Bobe-Wang/CMSIS_DAP-STM32/doc/719f01f6-3b62-4f19-8413-66b5557dca3e.png

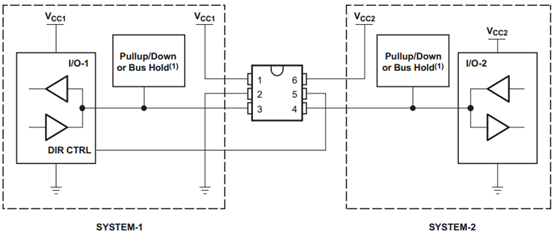
doc/719f01f6-3b62-4f19-8413-66b5557dca3e.png
