Bobe-Wang/CMSIS_DAP-STM32/原理图.pdf

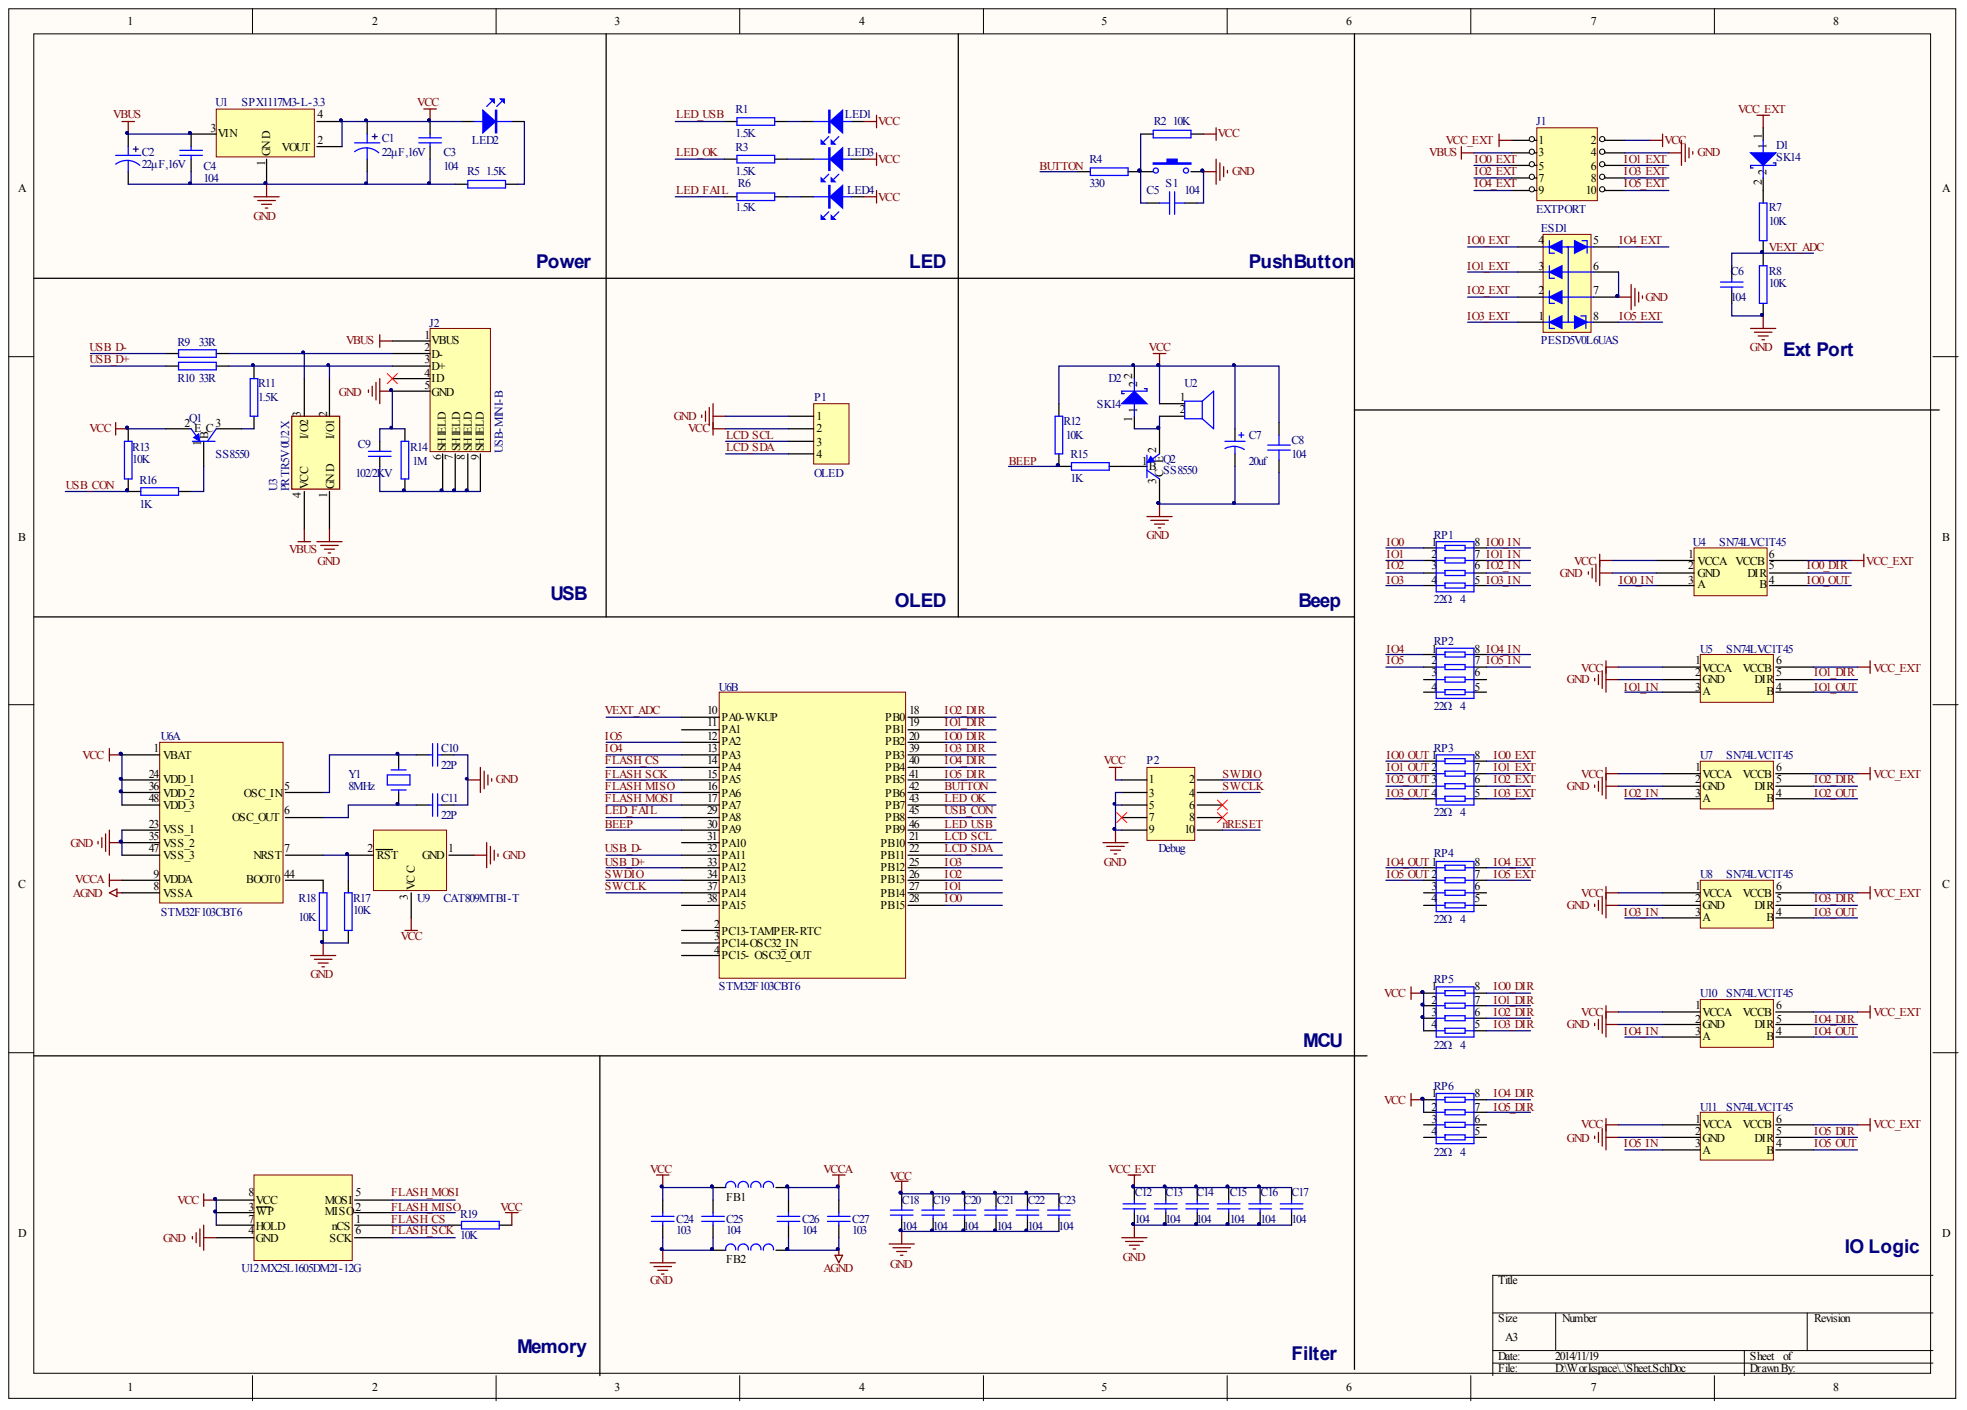
[picture p13: page 1]

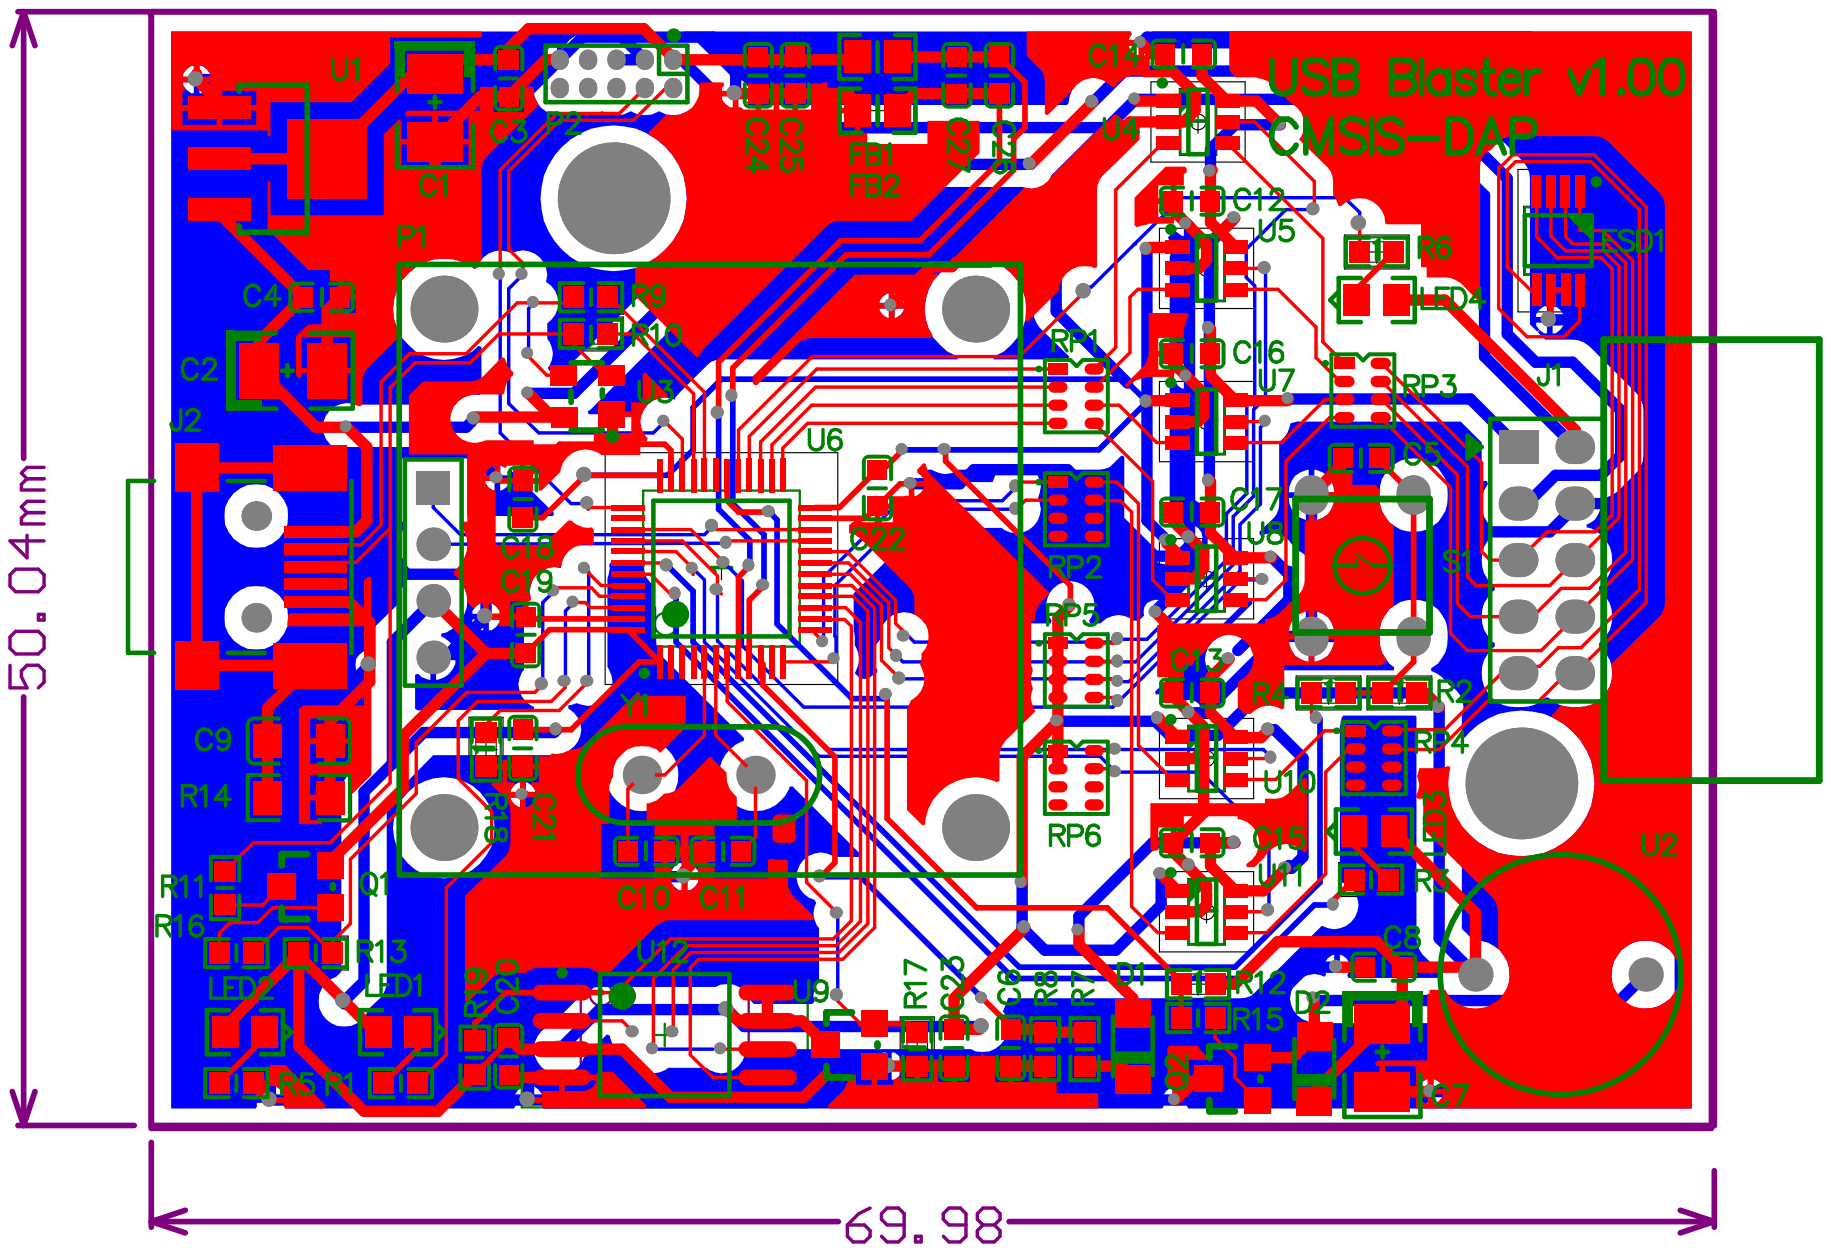
[picture p14: page 2]
