Bobe-Wang/CMSIS_DAP-STM32/code/Firmware/TinyICE/HID_MCBSTM32_LPC2138_TKScope.cfg

[Target]
Vendor=NXP
Device=LPC2138
HistoryVendorName0=
HistoryDeviceName0=
HistoryVendorName1=
HistoryDeviceName1=
HistoryVendorName2=
HistoryDeviceName2=
HistoryVendorName3=
HistoryDeviceName3=
[Emulator]
EmulatorType=K10
PodType=POD-JTAG-ARM-P20
EmulatorSN=0
[ConfigFile]
ConfigFile0=configuration\nxp\lpc21xx_iap1_512.flx
ConfigFile1=
ConfigFile2=
ConfigFile3=
ConfigFile4=hid_mcbstm32 lpc2138.ini
[Project]
ProjectName=HID_MCBSTM32.cfg
[CACHE]
CODE=0
DATA=0
[JTAG]
JtagFreq=1000
JtagFreqBak=100000
MinJtagFreq=1000
MaxJtagFreq=1200000
ResetHoldTime(ms)=0
ResetReleaseTime(ms)=0
ResetStrategy=CoreResetModeNo
HaltStrategy=HaltModeAuto
UseSWD=0
JtagClkMode=FixedJtagClock
UseLowFreqInit=0
UsenSRST=0
UsenTRST=0
AutoConfigJtag=0
ActiveDeviceID=0x0
ActiveDeviceNum=0
ActiveCoreNum=0
[Flash]
ProgramMode0=0
ProgramFlash0=0
Verify0=0
SkipMatch0=0
ProgramConfig0=0
EraseMode0=EraseNo
ResetAndRun0=0
UseDCC0=0
CommChannel0=0
FlashAlgoOffsetAdr0=0x0
FlashAlgoOffsetSize0=0x7d000
CodeRamAlgoOffsetAdr0=0x40000000
CodeRamAlgoOffsetSize0=0x1010
ProgramMode1=0
ProgramFlash1=0
Verify1=0
SkipMatch1=0
ProgramConfig1=0
EraseMode1=EraseNo
ResetAndRun1=0
UseDCC1=0
CommChannel1=0
FlashAlgoOffsetAdr1=0x0
FlashAlgoOffsetSize1=0x0
CodeRamAlgoOffsetAdr1=0x40000000
CodeRamAlgoOffsetSize1=0x0
ProgramMode2=0
ProgramFlash2=0
Verify2=0
SkipMatch2=0
ProgramConfig2=0
EraseMode2=EraseNo
ResetAndRun2=0
UseDCC2=0
CommChannel2=0
FlashAlgoOffsetAdr2=0x0
FlashAlgoOffsetSize2=0x0
CodeRamAlgoOffsetAdr2=0x40000000
CodeRamAlgoOffsetSize2=0x0
ProgramMode3=0
ProgramFlash3=0
Verify3=0
SkipMatch3=0
ProgramConfig3=0
EraseMode3=EraseNo
ResetAndRun3=0
UseDCC3=0
CommChannel3=0
FlashAlgoOffsetAdr3=0x0
FlashAlgoOffsetSize3=0x0
CodeRamAlgoOffsetAdr3=0x40000000
CodeRamAlgoOffsetSize3=0x0
[BaseDebug]
MemAccAttr=0
SoftStep=0
UseSoftWareBreakPoint=0
UseFlashBreakPoint=0
RunnigUpd=0
SysFreq=100000000
BreakTime=0
Endian=LittleEndian
DisableInitFile=0
[STANDARD ARM]
CaptureReset=0
CaptureUndef=0
CaptureSWI=0
CapturePabt=0
CaptureDabt=0
CaptureIRQ=0
CaptureFIQ=0
