Bobe-Wang/CMSIS_DAP-STM32/code/Firmware/TinyICE/HID_MCBSTM32_STM32F100xB_TKScope.cfg

[Target]
Vendor=STMicroelectronics
Device=STM32F100xB
HistoryVendorName0=
HistoryDeviceName0=
HistoryVendorName1=
HistoryDeviceName1=
HistoryVendorName2=
HistoryDeviceName2=
HistoryVendorName3=STMicroelectronics
HistoryDeviceName3=STM32F100xB
[Emulator]
EmulatorType=AK100pro
PodType=
EmulatorSN=500001189
[ConfigFile]
ConfigFile0=configuration\st\stm32f10x_128.flm
ConfigFile1=
ConfigFile2=
ConfigFile3=
ConfigFile4=hid_mcbstm32 stm32f100xb.ini
[Project]
ProjectName=HID_MCBSTM32.cfg
[CACHE]
CODE=1
DATA=1
[JTAG]
JtagFreq=100000
JtagFreqBak=800000
MinJtagFreq=100000
MaxJtagFreq=1200000
ResetHoldTime(ms)=506
ResetReleaseTime(ms)=500
ResetStrategy=CoreResetModeAuto
HaltStrategy=HaltModeAuto
UseSWD=1
JtagClkMode=FixedJtagClock
UseLowFreqInit=0
UsenSRST=1
UsenTRST=1
AutoConfigJtag=1
ActiveDeviceID=0x1BA01477
ActiveDeviceNum=0
ActiveCoreNum=0
[Flash]
ProgramMode0=0
ProgramFlash0=1
Verify0=1
SkipMatch0=0
ProgramConfig0=0
EraseMode0=EraseChip
ResetAndRun0=0
UseDCC0=0
CommChannel0=0
FlashAlgoOffsetAdr0=0x8000000
FlashAlgoOffsetSize0=0x20000
CodeRamAlgoOffsetAdr0=0x20000100
CodeRamAlgoOffsetSize0=0x960
ProgramMode1=0
ProgramFlash1=1
Verify1=1
SkipMatch1=0
ProgramConfig1=0
EraseMode1=EraseChip
ResetAndRun1=0
UseDCC1=0
CommChannel1=0
FlashAlgoOffsetAdr1=0x0
FlashAlgoOffsetSize1=0x0
CodeRamAlgoOffsetAdr1=0x20000100
CodeRamAlgoOffsetSize1=0x0
ProgramMode2=0
ProgramFlash2=1
Verify2=1
SkipMatch2=0
ProgramConfig2=0
EraseMode2=EraseChip
ResetAndRun2=0
UseDCC2=0
CommChannel2=0
FlashAlgoOffsetAdr2=0x0
FlashAlgoOffsetSize2=0x0
CodeRamAlgoOffsetAdr2=0x20000100
CodeRamAlgoOffsetSize2=0x0
ProgramMode3=0
ProgramFlash3=1
Verify3=1
SkipMatch3=0
ProgramConfig3=0
EraseMode3=EraseChip
ResetAndRun3=0
UseDCC3=0
CommChannel3=0
FlashAlgoOffsetAdr3=0x0
FlashAlgoOffsetSize3=0x0
CodeRamAlgoOffsetAdr3=0x20000100
CodeRamAlgoOffsetSize3=0x0
[BaseDebug]
MemAccAttr=15
SoftStep=1
UseSoftWareBreakPoint=1
UseFlashBreakPoint=1
RunnigUpd=1
SysFreq=12500000
BreakTime=0
Endian=LittleEndian
DisableInitFile=0
[STANDARD ARM]
CaptureReset=0
CaptureUndef=0
CaptureSWI=0
CapturePabt=0
CaptureDabt=0
CaptureIRQ=0
CaptureFIQ=0
