Bobe-Wang/CMSIS_DAP-STM32/(commit log)

2015-12-01 完成到STM32F103的移植。
    [HID_MCBSTM32_LPC2138_TKScope.cfg, HID_MCBSTM32_STM32F100xB_TKScope.cfg, HID_MCBSTM32_STM32F103C8_TKScope.cfg, HID_MCBSTM32_TKScope.cfg]
2016-01-23 Update README.md
    添加电路说明
2016-03-14 添加截图说明
2016-03-30 补充原理图
